cannon-zz/798-BC/(list of files, drawings)

Other design files:
MM5311/798-BC.pcb
MM5313/798-BC.pcb
