cannon-zz/798-BC/(commit log)

2025-01-14 version as built
    [798-BC.pcb, 798-BC.sch]
2025-01-14 reduce vias (now just 1)
    [798-BC.pcb]
2025-01-14 Active Surplus' version
    [798-BC.pcb, 798-BC.sch]
2025-01-14 first attempt at cleaning up Active Surplus' version
    [798-BC.pcb]
2025-01-14 MM5315 version cleaned up
    [798-BC.pcb]
